huzi-ctrl/split-keyboard/BOM.csv

Item | Qty | Supplier | Cost/item | Total Cost | link
SK6812MINI-E Reverse-Mount RGB LED, LCSC C5149201 (D43-D99) | 60 | LCSC | $0.07 | $4.20 | https://www.lcsc.com/product-detail/C5149201.html
PCF8574AP DIP-16 I2C I/O Expander, LCSC C398072 (U3, U4) | 3 | LCSC | $0.80 | $2.40 | https://www.lcsc.com/product-detail/C398072.html
Kailh CPG151101S11-16 MX Hot-Swap Socket, LCSC C41430893 (SW1-SW42) | 50 | LCSC | $0.04 | $2.00 | https://www.lcsc.com/product-detail/C41430893.html
1N4148 DO-35 Diode, LCSC C85057 (D1-D42) | 50 | LCSC | $0.01 | $0.50 | https://www.lcsc.com/product-detail/C85057.html
2N7000 TO-92 N-MOSFET, LCSC C9114 (Q1, Q2) | 10 | LCSC | $0.04 | $0.40 | https://www.lcsc.com/product-detail/C9114.html
JST S2B-PH-K-S(LF)(SN) 2-pin PH Header, LCSC C173752 (J1, J2) | 20 | LCSC | $0.04 | $0.80 | https://www.lcsc.com/product-detail/C173752.html
330 Ohm 1/4W 1% Axial Resistor, LCSC C119313 (R3, R4) | 50 | LCSC | $0.01 | $0.50 | https://www.lcsc.com/product-detail/C119313.html
47uF 25V Aluminum Electrolytic Cap D6.3mm, LCSC C45704 (C45, C46) | 20 | LCSC | $0.04 | $0.80 | https://www.lcsc.com/product-detail/C45704.html
100nF 50V X7R Ceramic Cap P=5.08mm, LCSC C84772 (C1-C42, C47, C48) | 50 | LCSC | $0.04 | $2.00 | https://www.lcsc.com/product-detail/C84772.html
ECE ESP4020 SPDT Slide Switch, LCSC C7472714 (SW43, SW44) | 3 | LCSC | $1.08 | $3.24 | https://www.lcsc.com/product-detail/C7472714.html
4.7k Ohm 1/4W 5% Axial Resistor, LCSC C120071 (R1, R2, R5-R10) | 100 | LCSC | $0.01 | $1.00 | https://www.lcsc.com/product-detail/C120071.html
AO3401A SOT-23 P-MOSFET, LCSC C15127 (Q3, Q4) | 5 | LCSC | $0.10 | $0.50 | https://www.lcsc.com/product-detail/C15127.html
10uF 50V Ceramic Cap TH, LCSC C53084650 (C43, C44) | 4 | LCSC | $0.87 | $3.48 | https://www.lcsc.com/product-detail/C53084650.html
Custom 2-layer split keyboard PCB, 5 pcs (unibody_pcb_v1.0.0_Y3) | 5 | JLCPCB | $4.62 | $23.10 | https://jlcpcb.com
Seeed Studio XIAO nRF52840 (U1, U2) | 2 | Unmanned Tech Shop | $11.99 | $23.98 | https://www.unmannedtechshop.co.uk/products/seeed-xiao-ble-nrf52840
503450 1000mAh 3.7V LiPo battery, 2 pcs JST plug | 1 | AliExpress | $3.07 | $3.07 | https://www.aliexpress.com/item/1005004375261361.html
0.91 inch 128x32 I2C SSD1306 OLED Display, 0x3C (J3, J4) | 2 | eBay UK (Hobby Stuff Ltd) | $5.16 | $10.32 | https://www.ebay.co.uk/itm/197218096311
Keygeek Full Nylon Linear Switches, 10 pack (SW1-SW42) | 5 | SerpentKeys | $4.42 | $22.10 | https://serpentkeys.co.uk
PBT Blank DSA Keycaps, 50 pcs, Translucent Black | 1 | Amazon UK | $14.73 | $14.73 | https://www.amazon.co.uk
Estimated total shipping | 1 |  |  | $24.57
