huzi-ctrl/split-keyboard/CAD/3mf/right.3MF

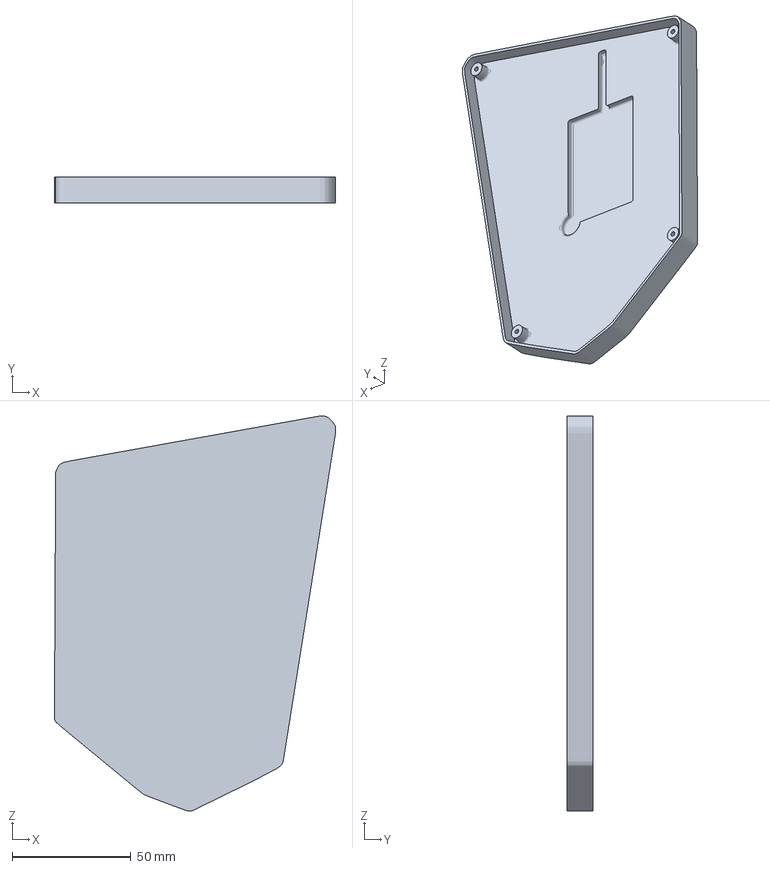
[picture p7: CAD file, 2026-10-28]
CAD/3mf/right.3MF
118.5 x 10.8 x 166.5 mm
