huzi-ctrl/split-keyboard/CAD/Keyboard.step

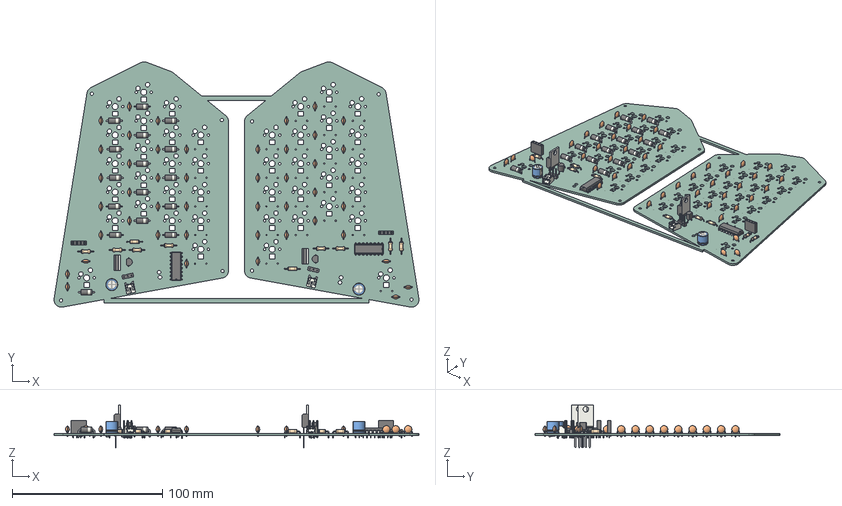
[picture p8: CAD file, 2026-10-28]
CAD/Keyboard.step
242.9 x 163.3 x 28.5 mm
C_Disc_D50mm_W25mm_P500mm x 46
JST_S2B_PH_K x 2
PinSocket_1x04_P2.54mm_Vertical x 2
CP_Radial_D80mm_P350mm x 2
D_DO-15_P10.16mm_Horizontal x 16
R_Axial_DIN0207_L63mm_D25mm_P1016mm_Horizontal x 10
TO-220-3_Vertical x 2
PinHeader_1x03_P254mm_Vertical x 2
DIP-16_W7.62mm x 2
TO-92-2_Wide x 2
KeyB941_PCB
