huzi-ctrl/split-keyboard/CAD/3mf/left.3MF

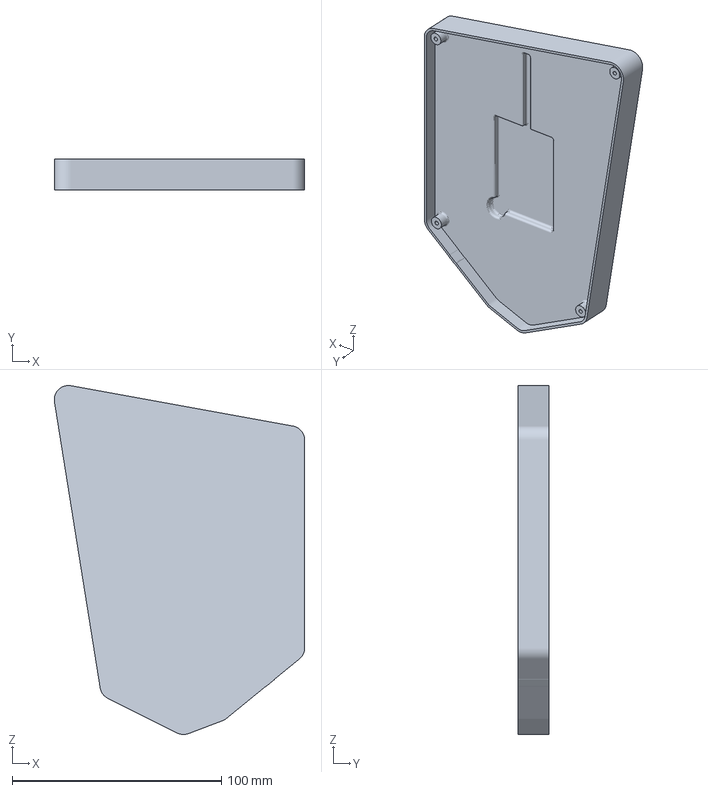
[picture p9: CAD file, 2026-10-28]
CAD/3mf/left.3MF
119.7 x 14.8 x 166.9 mm
