huzi-ctrl/split-keyboard/(list of files, cad)

Other CAD files:
CAD/Raw/right.SLDPRT
CAD/Raw/left.SLDPRT
