huzi-ctrl/split-keyboard/JOURNAL.md

# PKB (Printed KeyBoard): devlog

<!-- Generated by Half Life from project r6szcisp2tl5y8k4gpfn3l2b. Edits here are overwritten on the next sync. -->
<!-- Generated: 2026-11-01T11:37:00.012Z -->

> [!NOTE]
> This devlog is mirrored from [Half Life](https://halflife.hackclub.com) ([open the project](https://halflife.hackclub.com/projects/r6szcisp2tl5y8k4gpfn3l2b)). Editing it here will not change the platform's copy, and the next sync overwrites this file.

> PKB (Printed KeyBoard) is a custom 42-key wireless split mechanical keyboard designed from scratch in KiCad 10 and SolidWorks, powered by dual Seeed Studio XIAO nRF52840 microcontrollers running ZMK Firmware.

| Week | Tier | Hours logged | Entries |
| --- | --- | --- | --- |
| Week 4 | Tier 3 | 24h | 3 |

## Contents

1. [2026-11-01: Designed the Schematic from scratch including an I2C bus and switch matrices. I ran out of IO so had to use IO expander but that let me free up some pins that were hard to solder to making my life a l](#2026-11-01-designed-the-schematic-from-scratch-including-an-)
2. [2026-11-01: Routed the whole board, loads of issues with placement and routing, had to redo several bits of routing as well as keeping space clear for physical components, had to also look at mounting hardware an](#2026-11-01-routed-the-whole-board-loads-of-issues-with-place)
3. [2026-11-01: Did the CAD work to  design the enclosure for the Keyboard, and wrote the code for the](#2026-11-01-did-the-cad-work-to-design-the-enclosure-for-the-)

## Design

### 2026-11-01: Designed the Schematic from scratch including an I2C bus and switch matrices. I ran out of IO so had to use IO expander but that let me free up some pins that were hard to solder to making my life a l

**10h**

Designed the Schematic from scratch including an I2C bus and switch matrices. I ran out of IO so had to use IO expander but that let me free up some pins that were hard to solder to making my life a lot easier,

left_schem

right_schem





























### 2026-11-01: Routed the whole board, loads of issues with placement and routing, had to redo several bits of routing as well as keeping space clear for physical components, had to also look at mounting hardware an

**10h**

Routed the whole board, loads of issues with placement and routing, had to redo several bits of routing as well as keeping space clear for physical components, had to also look at mounting hardware and panellizing the board.

pcb_full





















### 2026-11-01: Did the CAD work to  design the enclosure for the Keyboard, and wrote the code for the

**4h**

Did the CAD work to  design the enclosure for the Keyboard, and wrote the code for the

left_cad

right_cad









































 firmware based on ZMK, CAD was the trickiest as i had to learn how to do CAD but managed with some tutorials etc.
