huzi-ctrl/split-keyboard/kicad/Keyboard.kicad_pcb

## KiCad design kicad/Keyboard.kicad_pcb (2026-10-28)

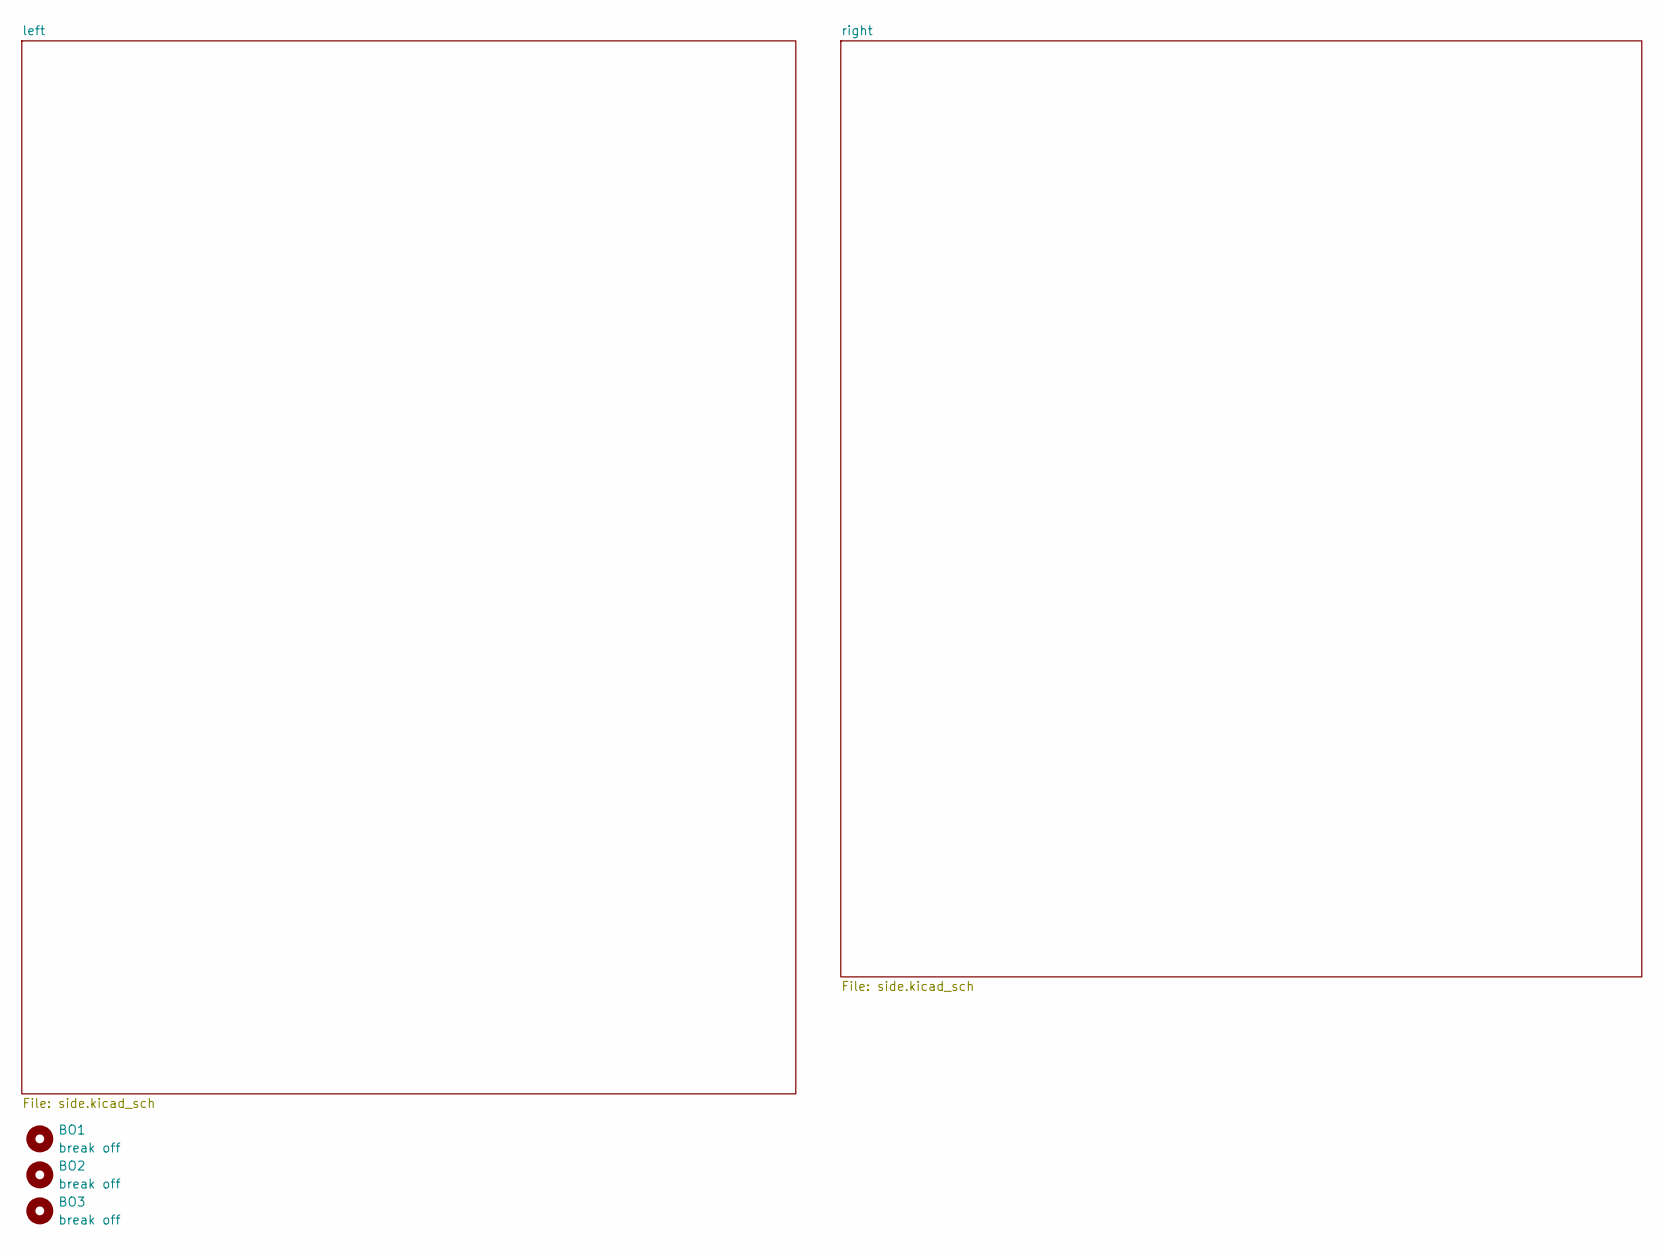
[picture p10: schematic Keyboard.kicad_sch]

Parts:
BO1, BO2, BO3: break off; MouseBite-Slot_2.0x4.5mm_outset_D0.5mm_P0.85mm_7h

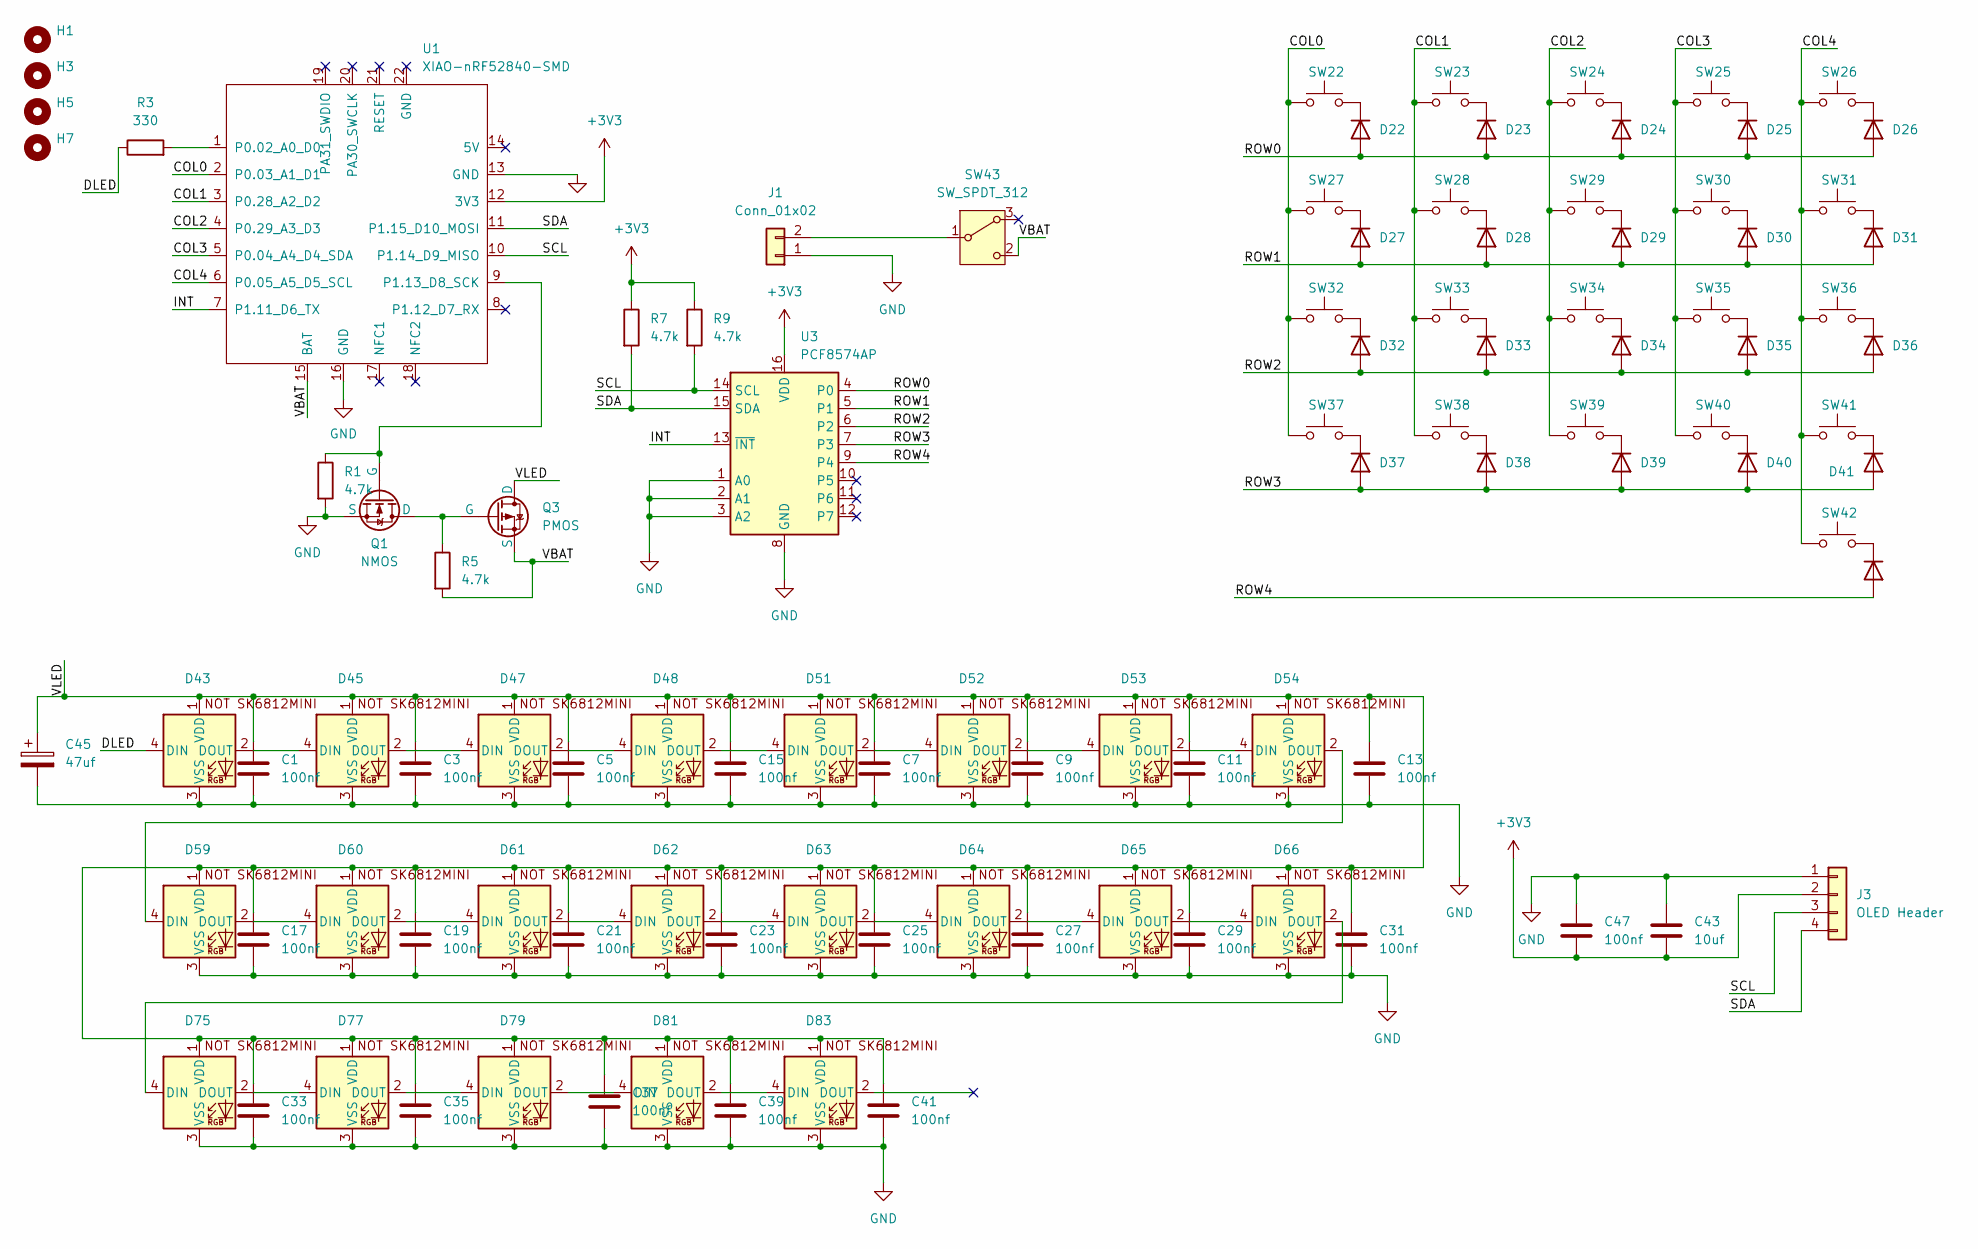
[picture p11: schematic side.kicad_sch]

Parts:
C1, C3, C5, C7, C9, C11, C13, C15, C17, C19, C21, C23, C25, C27, C29, C31, C33, C35, C37, C39, C41, C47: 100nf; C_Disc_D5.0mm_W2.5mm_P5.00mm
C43: 10uf; C_Disc_D5.0mm_W2.5mm_P5.00mm
C45: 47uf; CP_Radial_D8.0mm_P3.50mm
D22, D23, D24, D25, D26, D27, D28, D29, D30, D31, D32, D33, D34, D35, D36, D37, D38, D39, D40, D41, D42: D
D43, D45, D47, D48, D51, D52, D53, D54, D59, D60, D61, D62, D63, D64, D65, D66, D75, D77, D79, D81, D83: SK6812MINI-E
H1, H3, H5, H7: MountingHole; MountingHole_2.2mm_M2
J1: Conn_01x02; JST_PH_S2B-PH-K_1x02_P2.00mm_Horizontal
J3: OLED Header; PinSocket_1x04_P2.54mm_Vertical
Q1: NMOS; TO-92-2_Wide
Q3: PMOS; TO-220-3_Vertical
R1, R5, R7, R9: 4.7k; R_Axial_DIN0207_L6.3mm_D2.5mm_P10.16mm_Horizontal
R3: 330; R_Axial_DIN0207_L6.3mm_D2.5mm_P10.16mm_Horizontal
SW22, SW23, SW24, SW25, SW26, SW27, SW28, SW29, SW30, SW31, SW32, SW33, SW34, SW35, SW36, SW37, SW38, SW39, SW40, SW41, SW42: SW_Push
SW43: SW_SPDT_312; PinHeader_1x03_P2.54mm_Vertical
U1: XIAO-nRF52840-SMD; modified-XIAO-nRF52840-SMD
U3: PCF8574AP; DIP-16_W7.62mm

Connections:
+3V3: C43.2, C47.2, J3.2, R7.1, R9.1, U1.12 (3V3), U3.16 (VDD); also elsewhere on the board
/left/COL0: SW22.1, SW27.1, SW32.1, SW37.1, U1.2 (P0.03_A1_D1)
/left/COL1: SW23.1, SW28.1, SW33.1, SW38.1, U1.3 (P0.28_A2_D2)
/left/COL2: SW24.1, SW29.1, SW34.1, SW39.1, U1.4 (P0.29_A3_D3)
/left/COL3: SW25.1, SW30.1, SW35.1, SW40.1, U1.5 (P0.04_A4_D4_SDA)
/left/COL4: SW26.1, SW31.1, SW36.1, SW41.1, SW42.1, U1.6 (P0.05_A5_D5_SCL)
/left/DLED: D43.4 (DIN), R3.1
/left/INT: U1.7 (P1.11_D6_TX), U3.13 (~INT)
/left/ROW0: D22.2 (A), D23.2 (A), D24.2 (A), D25.2 (A), D26.2 (A), U3.4 (P0)
/left/ROW1: D27.2 (A), D28.2 (A), D29.2 (A), D30.2 (A), D31.2 (A), U3.5 (P1)
/left/ROW2: D32.2 (A), D33.2 (A), D34.2 (A), D35.2 (A), D36.2 (A), U3.6 (P2)
/left/ROW3: D37.2 (A), D38.2 (A), D39.2 (A), D40.2 (A), D41.2 (A), U3.7 (P3)
/left/ROW4: D42.2 (A), U3.9 (P4)
/left/SCL: J3.3, R9.2, U1.10 (P1.14_D9_MISO), U3.14 (SCL)
/left/SDA: J3.4, R7.2, U1.11 (P1.15_D10_MOSI), U3.15 (SDA)
/left/VBAT: Q3.3 (S), R5.2, SW43.2 (C), U1.15 (BAT)
/left/VLED: C1.1, C3.1, C5.1, C7.1, C9.1, C11.1, C13.1, C15.1, C17.1, C19.1, C21.1, C23.1, C25.1, C27.1, C29.1, C31.1, C33.1, C35.1, C37.1, C39.1, C41.1, C45.1, D43.1 (VDD), D45.1 (VDD), D47.1 (VDD), D48.1 (VDD), D51.1 (VDD), D52.1 (VDD), D53.1 (VDD), D54.1 (VDD), D59.1 (VDD), D60.1 (VDD), D61.1 (VDD), D62.1 (VDD), D63.1 (VDD), D64.1 (VDD), D65.1 (VDD), D66.1 (VDD), D75.1 (VDD), D77.1 (VDD), D79.1 (VDD), D81.1 (VDD), D83.1 (VDD), Q3.1 (D)
GND: C1.2, C3.2, C5.2, C7.2, C9.2, C11.2, C13.2, C15.2, C17.2, C19.2, C21.2, C23.2, C25.2, C27.2, C29.2, C31.2, C33.2, C35.2, C37.2, C39.2, C41.2, C43.1, C45.2, C47.1, D43.3 (VSS), D45.3 (VSS), D47.3 (VSS), D48.3 (VSS), D51.3 (VSS), D52.3 (VSS), D53.3 (VSS), D54.3 (VSS), D59.3 (VSS), D60.3 (VSS), D61.3 (VSS), D62.3 (VSS), D63.3 (VSS), D64.3 (VSS), D65.3 (VSS), D66.3 (VSS), D75.3 (VSS), D77.3 (VSS), D79.3 (VSS), D81.3 (VSS), D83.3 (VSS), J1.1, J3.1, Q1.3 (S), R1.2, U1.13 (GND), U1.16 (GND), U3.1 (A0), U3.2 (A1), U3.3 (A2), U3.8 (GND); also elsewhere on the board
unnamed: D22.1 (K), SW22.2
unnamed: D23.1 (K), SW23.2
unnamed: D24.1 (K), SW24.2
unnamed: D25.1 (K), SW25.2
unnamed: D26.1 (K), SW26.2
unnamed: D27.1 (K), SW27.2
unnamed: D28.1 (K), SW28.2
unnamed: D29.1 (K), SW29.2
unnamed: D30.1 (K), SW30.2
unnamed: D31.1 (K), SW31.2
unnamed: D32.1 (K), SW32.2
unnamed: D33.1 (K), SW33.2
unnamed: D34.1 (K), SW34.2
unnamed: D35.1 (K), SW35.2
unnamed: D36.1 (K), SW36.2
unnamed: D37.1 (K), SW37.2
unnamed: D38.1 (K), SW38.2
unnamed: D39.1 (K), SW39.2
unnamed: D40.1 (K), SW40.2
unnamed: D41.1 (K), SW41.2
unnamed: D42.1 (K), SW42.2
unnamed: D43.2 (DOUT), D45.4 (DIN)
unnamed: D45.2 (DOUT), D47.4 (DIN)
unnamed: D47.2 (DOUT), D48.4 (DIN)
unnamed: D48.2 (DOUT), D51.4 (DIN)
unnamed: D51.2 (DOUT), D52.4 (DIN)
unnamed: D52.2 (DOUT), D53.4 (DIN)
unnamed: D53.2 (DOUT), D54.4 (DIN)
unnamed: D54.2 (DOUT), D59.4 (DIN)
unnamed: D59.2 (DOUT), D60.4 (DIN)
unnamed: D60.2 (DOUT), D61.4 (DIN)
unnamed: D61.2 (DOUT), D62.4 (DIN)
unnamed: D62.2 (DOUT), D63.4 (DIN)
unnamed: D63.2 (DOUT), D64.4 (DIN)
unnamed: D64.2 (DOUT), D65.4 (DIN)
unnamed: D65.2 (DOUT), D66.4 (DIN)
unnamed: D66.2 (DOUT), D75.4 (DIN)
unnamed: D75.2 (DOUT), D77.4 (DIN)
unnamed: D77.2 (DOUT), D79.4 (DIN)
unnamed: D79.2 (DOUT), D81.4 (DIN)
unnamed: D81.2 (DOUT), D83.4 (DIN)
unnamed: J1.2, SW43.1 (B)
unnamed: Q1.1 (D), Q3.2 (G), R5.1
unnamed: Q1.2 (G), R1.1, U1.9 (P1.13_D8_SCK)
unnamed: R3.2, U1.1 (P0.02_A0_D0)

Parts of its further copies:
C2, C4, C6, C8, C10, C12, C14, C16, C18, C20, C22, C24, C26, C28, C30, C32, C34, C36, C38, C40, C42, C48: 100nf; C_Disc_D5.0mm_W2.5mm_P5.00mm
C44: 10uf; C_Disc_D5.0mm_W2.5mm_P5.00mm
C46: 47uf; CP_Radial_D8.0mm_P3.50mm
D1, D2, D3, D4, D5, D6, D7, D8, D9, D10, D11, D12, D13, D14, D15, D16, D17, D18, D19, D20, D21: D
D44, D46, D49, D50, D55, D56, D57, D58, D67, D68, D69, D70, D71, D72, D73, D74, D91, D93, D95, D97, D99: SK6812MINI-E
H2, H4, H6, H8: MountingHole; MountingHole_2.2mm_M2
J2: Conn_01x02; JST_PH_S2B-PH-K_1x02_P2.00mm_Horizontal
J4: OLED Header; PinSocket_1x04_P2.54mm_Vertical
Q2: NMOS; TO-92-2_Wide
Q4: PMOS; TO-220-3_Vertical
R2, R6, R8, R10: 4.7k; R_Axial_DIN0207_L6.3mm_D2.5mm_P10.16mm_Horizontal
R4: 330; R_Axial_DIN0207_L6.3mm_D2.5mm_P10.16mm_Horizontal
SW1, SW2, SW3, SW4, SW5, SW6, SW7, SW8, SW9, SW10, SW11, SW12, SW13, SW14, SW15, SW16, SW17, SW18, SW19, SW20, SW21: SW_Push
SW44: SW_SPDT_312; PinHeader_1x03_P2.54mm_Vertical
U2: XIAO-nRF52840-SMD; modified-XIAO-nRF52840-SMD
U4: PCF8574AP; DIP-16_W7.62mm

Connections of its further copies:
+3V3: C44.2, C48.2, J4.2, R8.1, R10.1, U2.12 (3V3), U4.16 (VDD); also elsewhere on the board
/right/COL0: SW1.1, SW6.1, SW11.1, SW16.1, U2.2 (P0.03_A1_D1)
/right/COL1: SW2.1, SW7.1, SW12.1, SW17.1, U2.3 (P0.28_A2_D2)
/right/COL2: SW3.1, SW8.1, SW13.1, SW18.1, U2.4 (P0.29_A3_D3)
/right/COL3: SW4.1, SW9.1, SW14.1, SW19.1, U2.5 (P0.04_A4_D4_SDA)
/right/COL4: SW5.1, SW10.1, SW15.1, SW20.1, SW21.1, U2.6 (P0.05_A5_D5_SCL)
/right/DLED: D44.4 (DIN), R4.1
/right/INT: U2.7 (P1.11_D6_TX), U4.13 (~INT)
/right/ROW0: D1.2 (A), D2.2 (A), D3.2 (A), D4.2 (A), D5.2 (A), U4.4 (P0)
/right/ROW1: D6.2 (A), D7.2 (A), D8.2 (A), D9.2 (A), D10.2 (A), U4.5 (P1)
/right/ROW2: D11.2 (A), D12.2 (A), D13.2 (A), D14.2 (A), D15.2 (A), U4.6 (P2)
/right/ROW3: D16.2 (A), D17.2 (A), D18.2 (A), D19.2 (A), D20.2 (A), U4.7 (P3)
/right/ROW4: D21.2 (A), U4.9 (P4)
/right/SCL: J4.3, R10.2, U2.10 (P1.14_D9_MISO), U4.14 (SCL)
/right/SDA: J4.4, R8.2, U2.11 (P1.15_D10_MOSI), U4.15 (SDA)
/right/VBAT: Q4.3 (S), R6.2, SW44.2 (C), U2.15 (BAT)
/right/VLED: C2.1, C4.1, C6.1, C8.1, C10.1, C12.1, C14.1, C16.1, C18.1, C20.1, C22.1, C24.1, C26.1, C28.1, C30.1, C32.1, C34.1, C36.1, C38.1, C40.1, C42.1, C46.1, D44.1 (VDD), D46.1 (VDD), D49.1 (VDD), D50.1 (VDD), D55.1 (VDD), D56.1 (VDD), D57.1 (VDD), D58.1 (VDD), D67.1 (VDD), D68.1 (VDD), D69.1 (VDD), D70.1 (VDD), D71.1 (VDD), D72.1 (VDD), D73.1 (VDD), D74.1 (VDD), D91.1 (VDD), D93.1 (VDD), D95.1 (VDD), D97.1 (VDD), D99.1 (VDD), Q4.1 (D)
GND: C2.2, C4.2, C6.2, C8.2, C10.2, C12.2, C14.2, C16.2, C18.2, C20.2, C22.2, C24.2, C26.2, C28.2, C30.2, C32.2, C34.2, C36.2, C38.2, C40.2, C42.2, C44.1, C46.2, C48.1, D44.3 (VSS), D46.3 (VSS), D49.3 (VSS), D50.3 (VSS), D55.3 (VSS), D56.3 (VSS), D57.3 (VSS), D58.3 (VSS), D67.3 (VSS), D68.3 (VSS), D69.3 (VSS), D70.3 (VSS), D71.3 (VSS), D72.3 (VSS), D73.3 (VSS), D74.3 (VSS), D91.3 (VSS), D93.3 (VSS), D95.3 (VSS), D97.3 (VSS), D99.3 (VSS), J2.1, J4.1, R2.2, U2.13 (GND), U2.16 (GND), U4.1 (A0), U4.2 (A1), U4.3 (A2), U4.8 (GND); also elsewhere on the board
unnamed: D1.1 (K), SW1.2
unnamed: D2.1 (K), SW2.2
unnamed: D3.1 (K), SW3.2
unnamed: D4.1 (K), SW4.2
unnamed: D5.1 (K), SW5.2
unnamed: D6.1 (K), SW6.2
unnamed: D7.1 (K), SW7.2
unnamed: D8.1 (K), SW8.2
unnamed: D9.1 (K), SW9.2
unnamed: D10.1 (K), SW10.2
unnamed: D11.1 (K), SW11.2
unnamed: D12.1 (K), SW12.2
unnamed: D13.1 (K), SW13.2
unnamed: D14.1 (K), SW14.2
unnamed: D15.1 (K), SW15.2
unnamed: D16.1 (K), SW16.2
unnamed: D17.1 (K), SW17.2
unnamed: D18.1 (K), SW18.2
unnamed: D19.1 (K), SW19.2
unnamed: D20.1 (K), SW20.2
unnamed: D21.1 (K), SW21.2
unnamed: D44.2 (DOUT), D46.4 (DIN)
unnamed: D46.2 (DOUT), D49.4 (DIN)
unnamed: D49.2 (DOUT), D50.4 (DIN)
unnamed: D50.2 (DOUT), D55.4 (DIN)
unnamed: D55.2 (DOUT), D56.4 (DIN)
unnamed: D56.2 (DOUT), D57.4 (DIN)
unnamed: D57.2 (DOUT), D58.4 (DIN)
unnamed: D58.2 (DOUT), D67.4 (DIN)
unnamed: D67.2 (DOUT), D68.4 (DIN)
unnamed: D68.2 (DOUT), D69.4 (DIN)
unnamed: D69.2 (DOUT), D70.4 (DIN)
unnamed: D70.2 (DOUT), D71.4 (DIN)
unnamed: D71.2 (DOUT), D72.4 (DIN)
unnamed: D72.2 (DOUT), D73.4 (DIN)
unnamed: D73.2 (DOUT), D74.4 (DIN)
unnamed: D74.2 (DOUT), D91.4 (DIN)
unnamed: D91.2 (DOUT), D93.4 (DIN)
unnamed: D93.2 (DOUT), D95.4 (DIN)
unnamed: D95.2 (DOUT), D97.4 (DIN)
unnamed: D97.2 (DOUT), D99.4 (DIN)
unnamed: J2.2, SW44.1 (B)
unnamed: Q2.1 (D), Q4.2 (G), R6.1
unnamed: Q2.2 (G), R2.1, U2.9 (P1.13_D8_SCK)
unnamed: R4.2, U2.1 (P0.02_A0_D0)

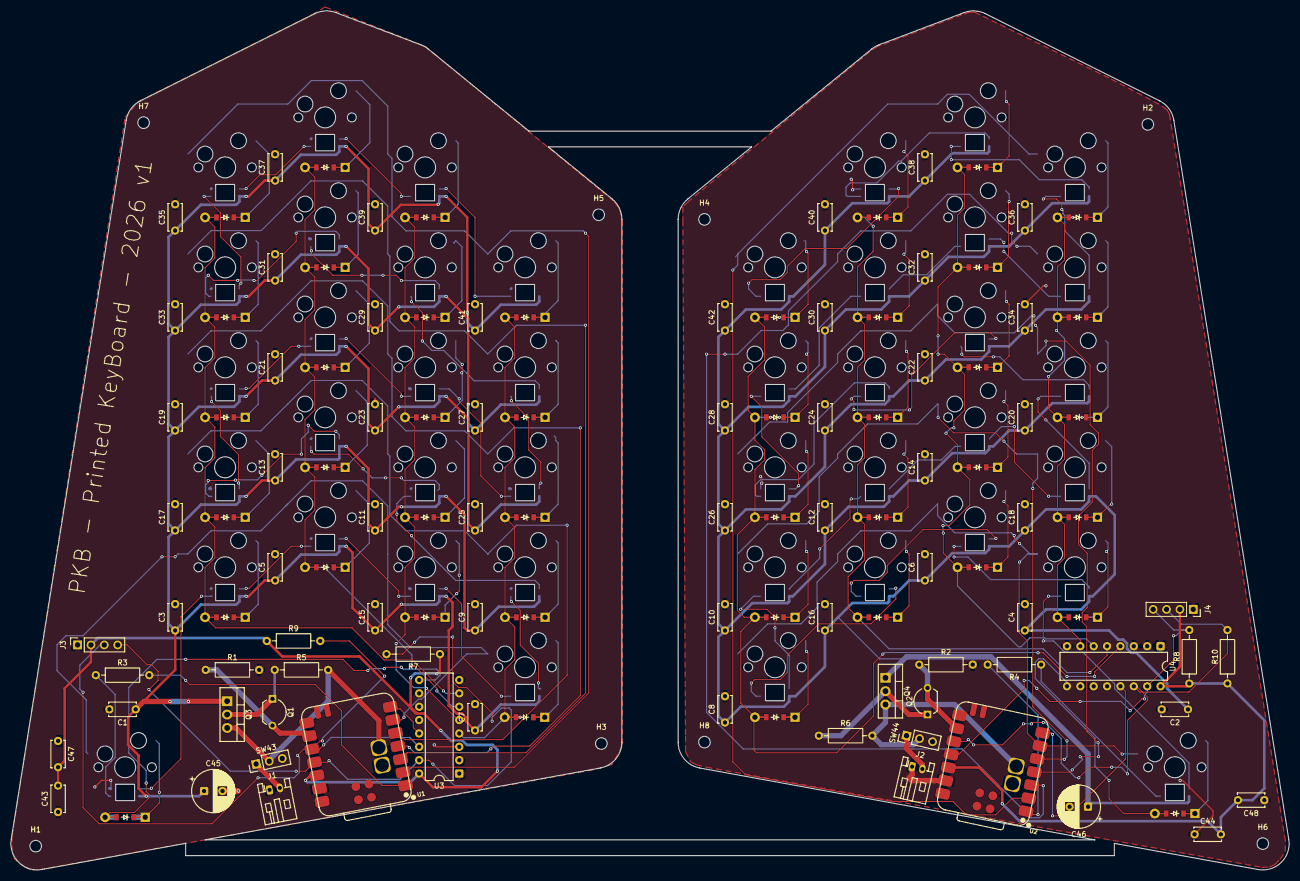
[picture p12: board Keyboard.kicad_pcb from above]

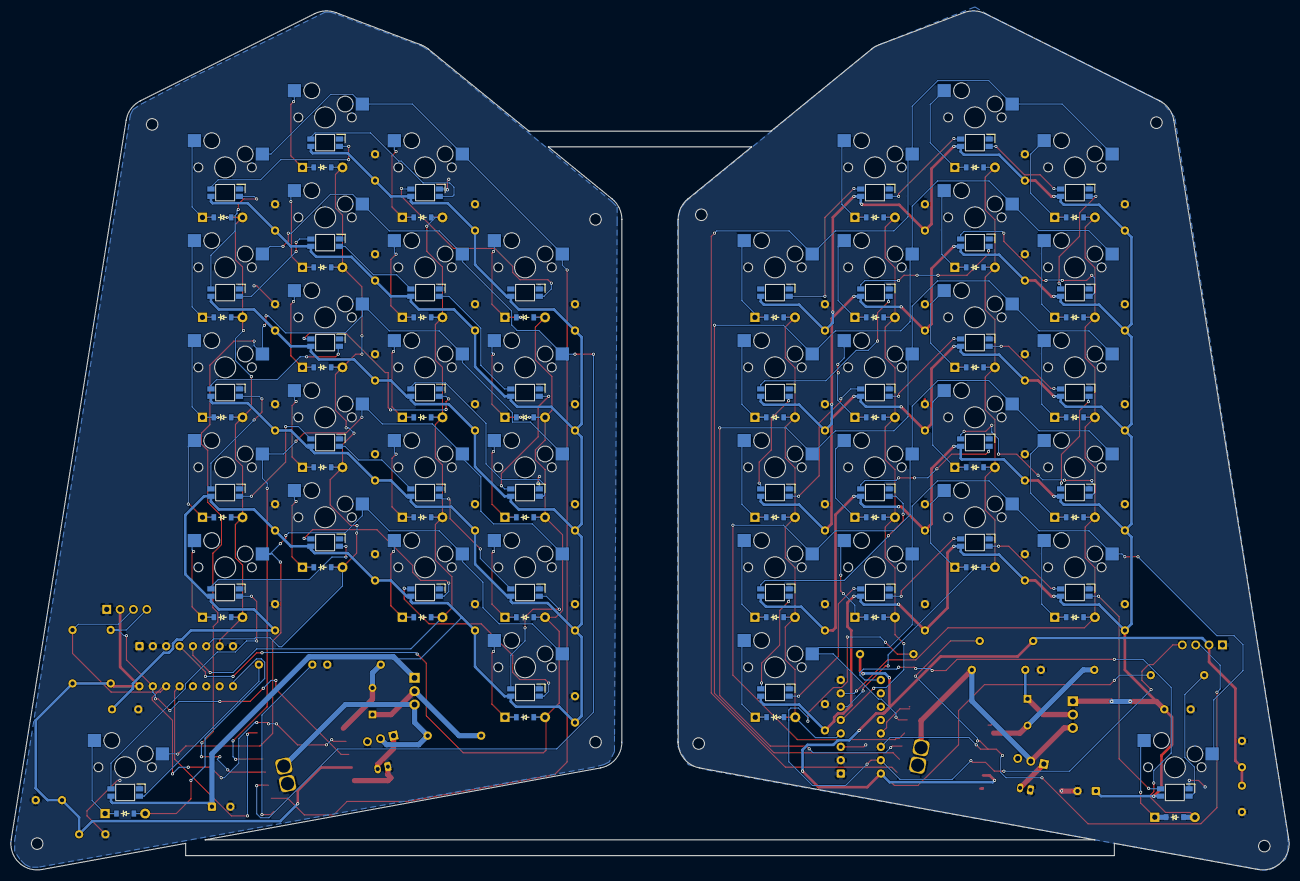
[picture p13: board Keyboard.kicad_pcb from below]

Board: 2 copper layers, 242.9 x 163.3 mm, 206 parts (42 on the bottom side), 124 nets.
