huzi-ctrl/split-keyboard/(commit log)

2026-10-27 Fix PCF8574 binding (nxp,pcf8574) and i2c0 pinctrl for Zephyr 3.5
2026-10-27 Optimize 128x32 OLED layout (battery %, auto-blank) and add BT/Power/RGB controls to Layer 2
2026-10-28 Add project README, 3D PCB render, STEP file, and complete KiCad sources
2026-10-28 Add ZMK C shield status module and optimize KiCad files for KiCanvas
2026-10-28 Add comprehensive 7-step Build & Assembly Guide to README
2026-10-28 Sync PKB (Printed KeyBoard) from Half Life
